MirzaBasic2023/SmartStopwatch/picture3.jpg

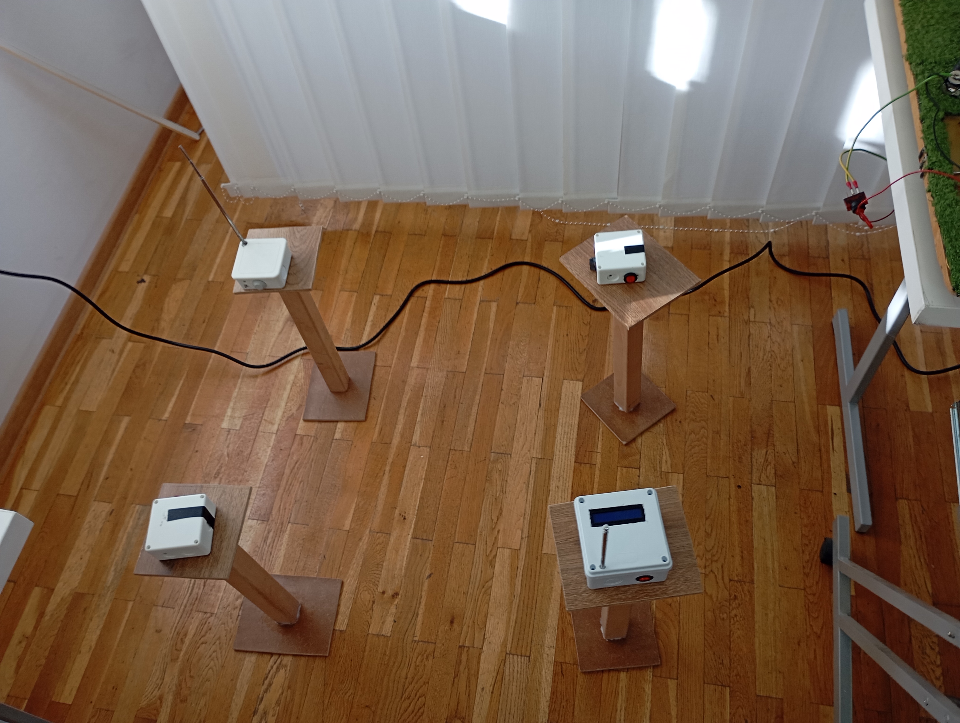
picture3.jpg
