MirzaBasic2023/SmartStopwatch/picture4.jpg

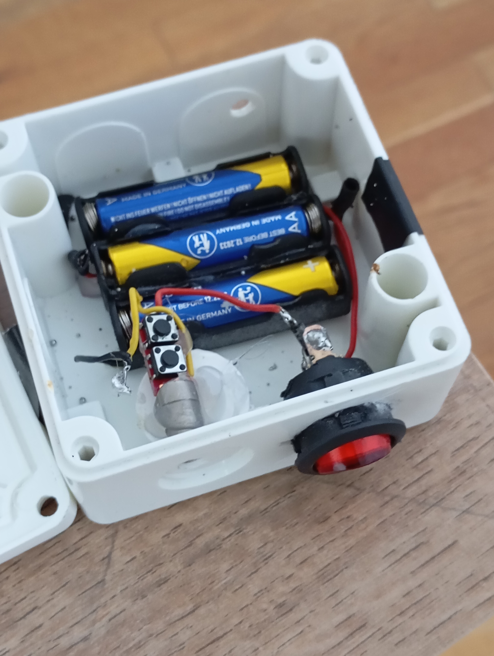
picture4.jpg
