MirzaBasic2023/SmartStopwatch/README.md

# SmartStopwatch
Smart stopwatch which can be used in measuring time required to travel some distance of a moving object. Project is using Arduino Nano along with a Liquid Crystal display.

There are 2 lasers along with a phototransistor (those two are in pair). Triggering START laser, it sends an impulse using a radio transmitter to
the radio receiver. Information is, then, processed and registered by Arduino Nano and race starts. Triggering the START laser after the first trigger is useless (it doesn't bear any fruit). Triggering STOP laser, race stops and the elapsed time is printed on the display.
Project is equiped with monopole antennas that can work up to 100m radius. Also, project is not perfect and has a problem with 
photo sensitivity of transistors.

**Notice: This project produces electromagnetic radiation which can trigger car alarms and be a distraction / obstruction in wireless communication.**

Copyright © 2024 by Srednja tehnička škola Bugojno. All rights reserved.
Fell free to use this project as inspiration and improving design of your projects, but not for any monetary gain and criminal activities.

Project manager by Said Karaosmanović

Project assistant by Mirza Bašić

Hardware by Tarik Redžić

Software by Edhem Krivdić

Github:

Mirza Bašić: 
https://github.com/MirzaBasic2023

Edhem Krivdić: 
https://github.com/Edo3214

Tarik Redžić:
https://github.com/TarikRedzic

In this project, it is provided the following:
* Schematic
* Documentation of the project in Bosnian language
* Pictures of finished project
* Arduino Code
