MirzaBasic2023/SmartStopwatch/picture1.jpg

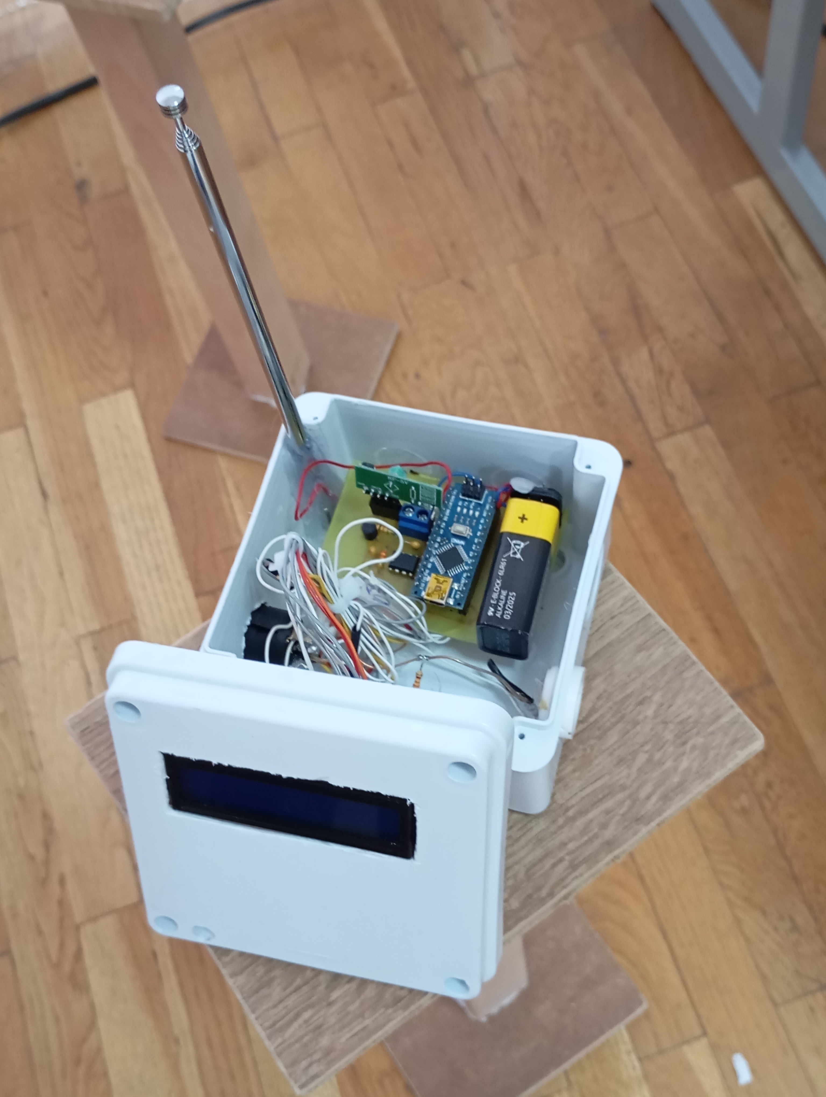
picture1.jpg
