MirzaBasic2023/SmartStopwatch/picture2.jpg

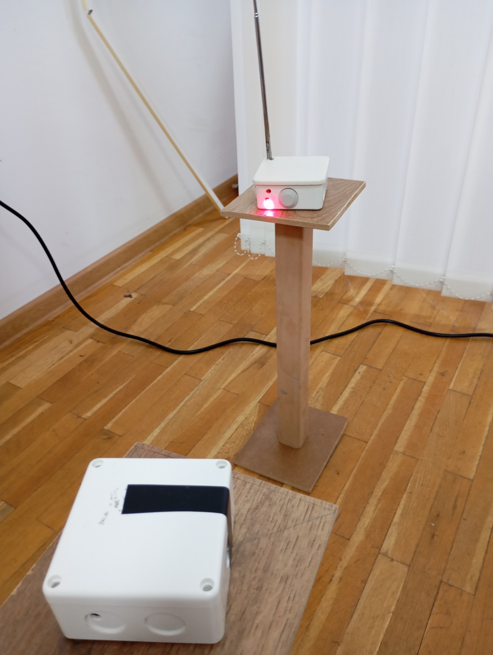
picture2.jpg
