MirzaBasic2023/SmartStopwatch/picture5.jpg

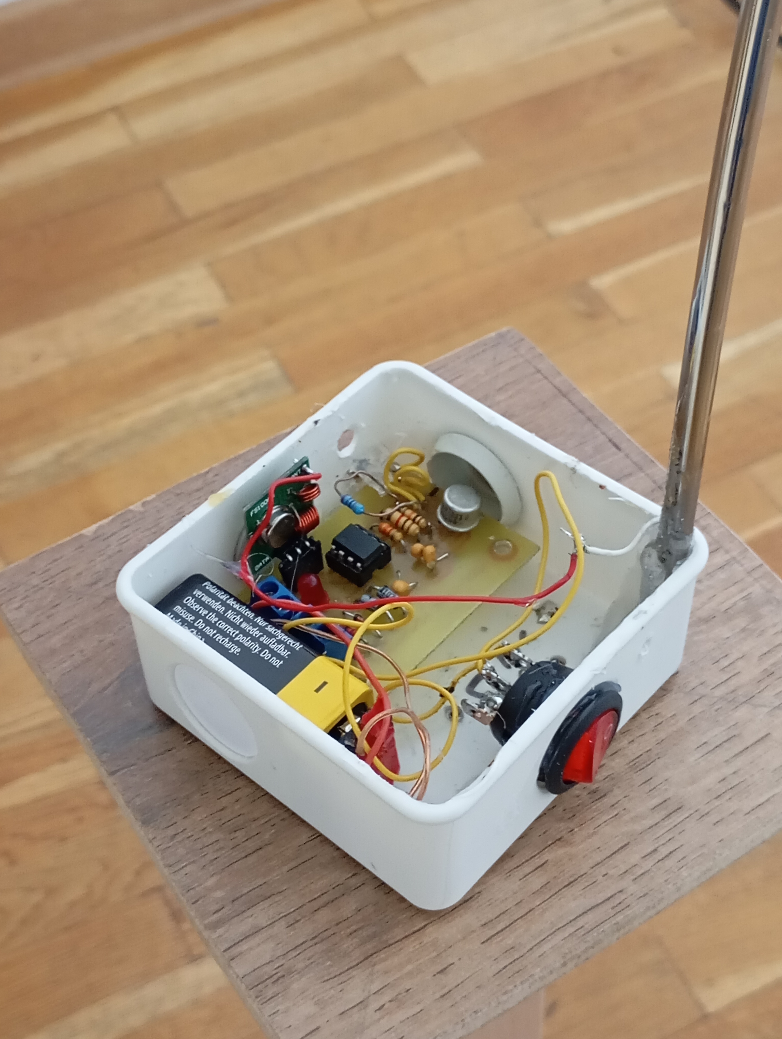
picture5.jpg
