MirzaBasic2023/SmartStopwatch/receiver.BMP

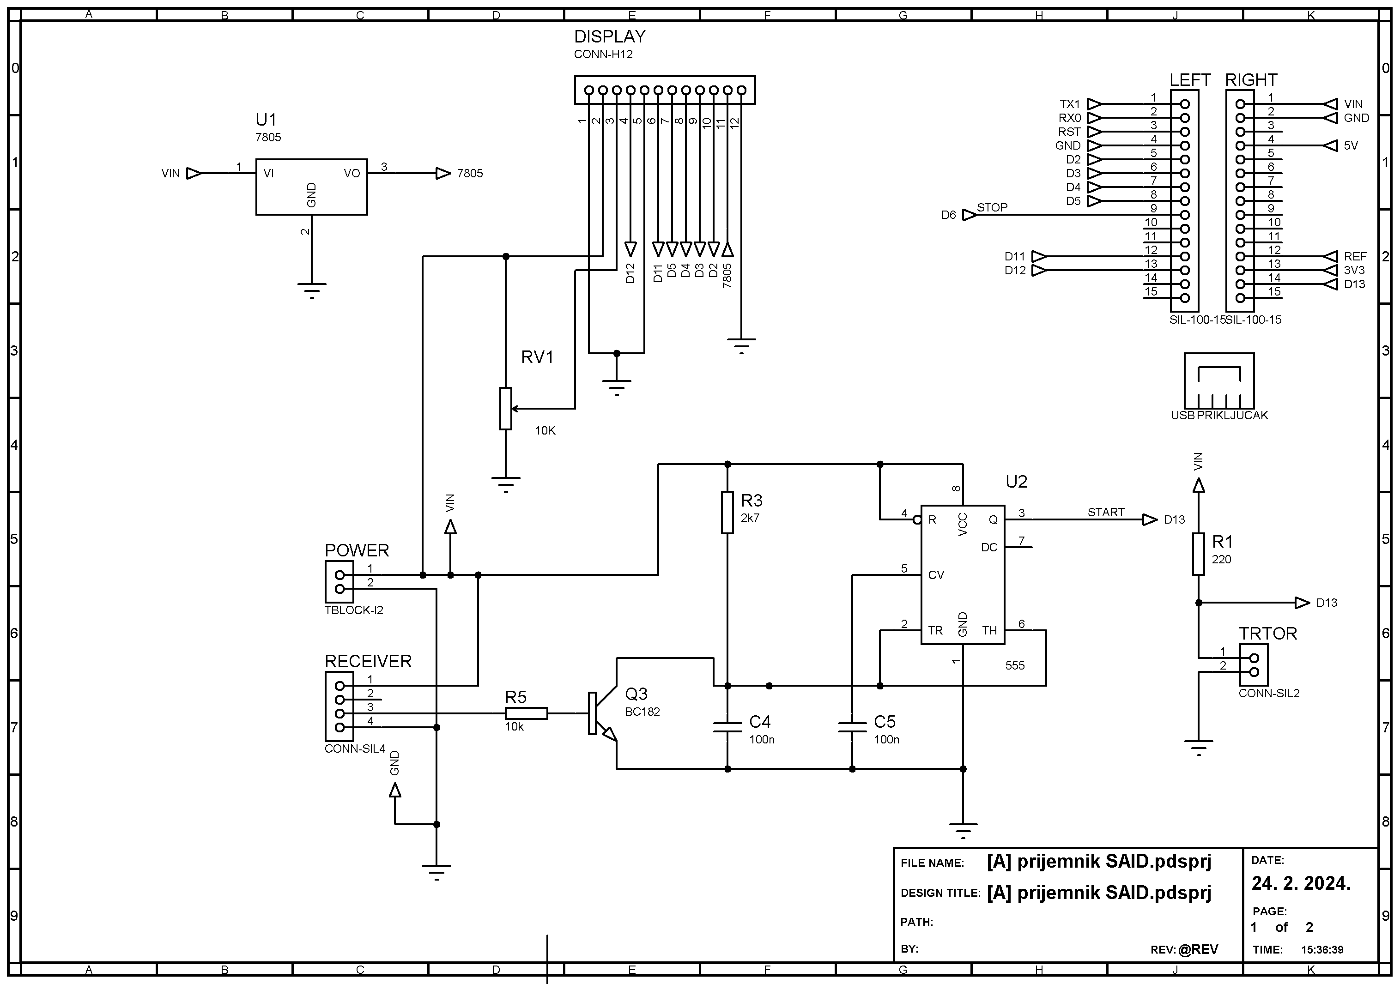
receiver.BMP
