MirzaBasic2023/SmartStopwatch/transmitter.BMP

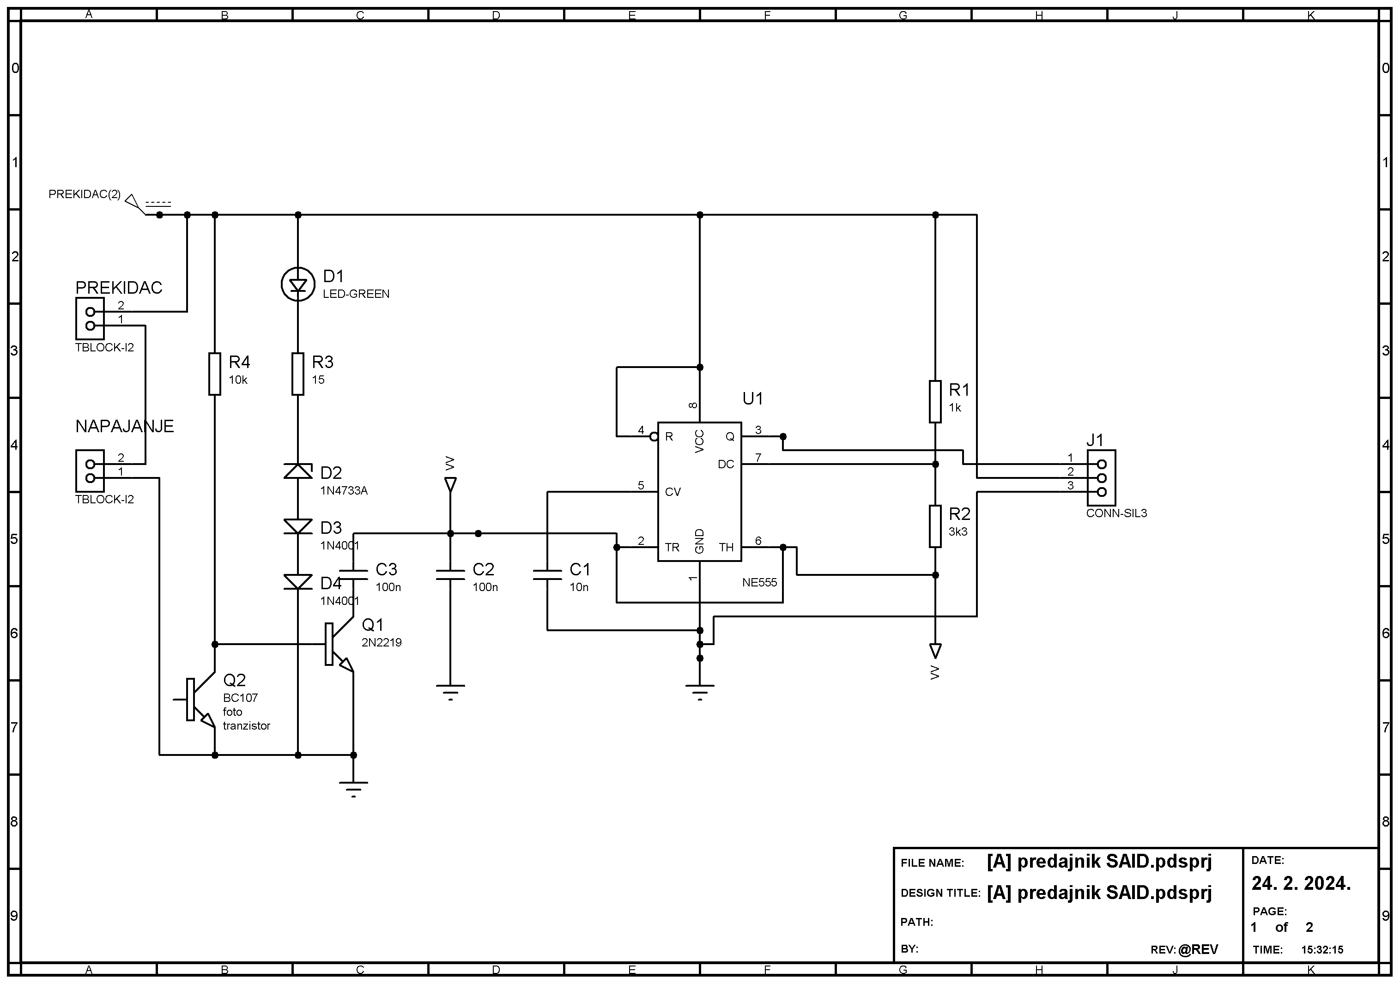
transmitter.BMP
